utkarshminblr/PexTypo/Img/Screenshot 2026-10-20 132050.png

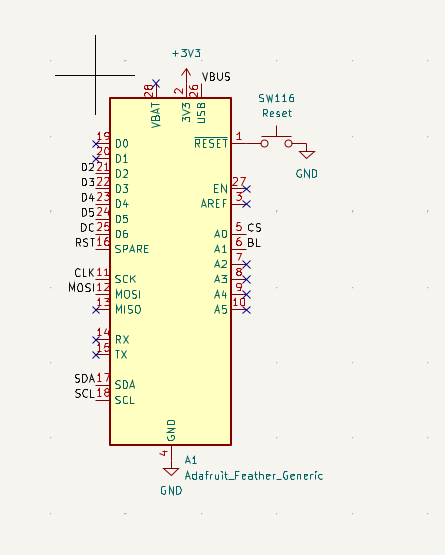
Img/Screenshot 2026-10-20 132050.png
