utkarshminblr/PexTypo/Img/Screenshot 2026-10-20 132104.png

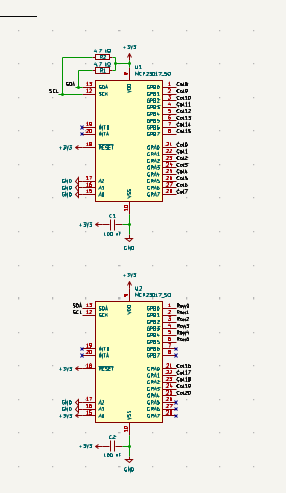
Img/Screenshot 2026-10-20 132104.png
