utkarshminblr/PexTypo/bom.csv

Name | Quantity | Total Cost ($) | Link | Distributor
3D-printed Case | 1 | 8 | https://printlegion.hackclub.com | Hack Club
PCB fabrication | 1 | 39.36 | https://cart.jlcpcb.com/shopcart/cart | JLCPCB
HITIME XVX Plum Blossom Shine Through Side Print Custom 75 Percent Dye Sub and Double Shot Keycaps, 136 Keys Cherry Profile Mechanical Keyboard Set | 1 | 43.47 | https://amzn.in/d/03Cm0nP8 | Amazon
DUROCK Stabilizers V3, Screw in Stabilizers with 2u, 6.25u, 7u Wires, PCB Mount for Mechanical Keyboards (Smokey 80% Kit) | 1 | 29.02 | https://amzn.in/d/09qbkcYf | Amazon
Akko V3 Creamy Blue Pro Keyboard Switch with Dustproof Stem for Mechanical Gaming Keyboard, 5-Pin 45gf Pre Lubed Tactile Key Switches (45pcs) | 3 | 81.03 | https://amzn.in/d/0btpna3L | Amazon
Adafruit Feather nRF52840 Express | 1 | 33.10 | https://www.theengineerstore.in/ta/products/adafruit-feather-nrf52840-express | theengineerstore
3.7V 500mAh LiPo Rechargeable Battery HCY-602030 | Lithium Polymer Battery Pack | DIY Projects, GPS, IoT Devices (Pack of 1) | 1 | 2.91 | https://amzn.in/d/0axbzTSW | Amazon
0.1uF/25V (100nF/25V) SMD Capacitor 0805 10% (Moq of 50) | 10 | 1.09 | https://amzn.in/d/02mNlnPe | Amazon
CL21B475KPQVPNE-Samsung-Cap Ceramic 4.7uF 10V X7R 10% Pad SMD 0805 125°C T/R Automotive AEC-Q200 | 5 | 0.16 | https://robu.in/product/cl21b475kpqvpne-samsung-cap-ceramic-4-7uf-10v-x7r-10-pad-smd-0805-125c-t-r-automotive-aec-q200/ | Robu
1N4148W SOD-123 1206 Diode | 216 | 1.65 | https://robu.in/product/1n4148w-sod-123-1206-diodereel-of-3000/ | Robu
3mm Green DIP LED | 15 | 0.14 | https://robu.in/product/3mm-green-dip-led-pack-of-50/ | Robu
3mm Red DIP LED | 15 | 0.13 | https://robu.in/product/3mm-red-dip-led-pack-of-50/ | Robu
TYPE-C-31-M-12-Hroparts-5A 1 16P Female Type-C SMD USB Connectors ROHS | 2 | 0.54 | https://robu.in/product/type-c-31-m-12-hroparts-5a-1-16p-female-type-c-smd-usb-connectors-rohs/ | Robu
SM08B-SRSS-TB(LF)(SN)-JST-1x8P 8P SH Tin 8 -25°C to +85°C 1A 1mm Copper Alloy Surface Mount SMD, P=1mm, Right Angle Wire-to-Board Connector ROHS | 2 | 1.56 | https://robu.in/product/sm08b-srss-tblfsn-jst-1x8p-8p-sh-tin-8-25%e2%84%8385%e2%84%83-1a-1-1mm-copper-alloy-surface-mount-smdp1mmsurface-mount%ef%bc%8cright-a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 | Robu
ERJ6ENF4701V-PANASONIC-SMD Chip Resistor, 4.7 kohm, ± 1%, 125 mW, 0805 [2012 Metric], Thick Film, Precision (MOQ 16) | 11 | 0.11 | https://robu.in/product/erj6enf4701v-panasonic-smd-chip-resistor-4-7-kohm-%c2%b1-1-125-mw-0805-2012-metric-thick-film-precision/ | Robu
CRCW08051K00FKEAHP-VISHAY-SMD Chip Resistor, 1 kohm, ± 1%, 500 mW, 0805 [2012 Metric], Thick Film, Pulse Proof, High Power | 20 | 0.66 | https://robu.in/product/crcw08051k00fkeahp-vishay-smd-chip-resistor-1-kohm-%c2%b1-1-500-mw-0805-2012-metric-thick-film-pulse-proof-high-power/ | Robu
RC0805JR-075K1L-Yageo-SMD Chip Resistor, 5.1 kohm, ± 5%, 125 mW, 0805 [2012 Metric], Thick Film, General Purpose | 100 | 0.18 | https://robu.in/product/rc0805jr-075k1l-yageo-smd-chip-resistor-5-1-kohm-%c2%b1-5-125-mw-0805-2012-metric-thick-film-general-purpose/ | Robu
MCP23017-E/SO MICROCHIP I/O Expander, 16 bit, I2C, Serial, 1.8 V, 5.5 V, SOIC, 28 Pins | 4 | 12.29 | https://robu.in/product/mcp23017-e-so-microchip-i-o-expander-16-bit-i2c-serial-1-8-v-5-5-v-soic-28-pins/ | Robu
USBLC6-2SC6-MS-MSKSEMI-4.5A 15V 150W 6V 5V SOT-23-6 ESD and Surge Protection (TVS/ESD) ROHS | 5 | 0.57 | https://robu.in/product/usblc6-2sc6-ms-msksemi-4-5a-15v-150w-6v-5v-sot-23-6-esd-and-surge-protection-tvs-esd-rohs/ | Robu
Waveshare 1.9inch LCD Display Module, SPI Interface, IPS, 262K Colors | 1 | 11.66 | https://robu.in/product/waveshare-lcd-display-module-spi-interface-262k-colors/ | Robu
Total |  | 267.64
