utkarshminblr/PexTypo/BOM img/Screenshot 2026-10-20 174808.png

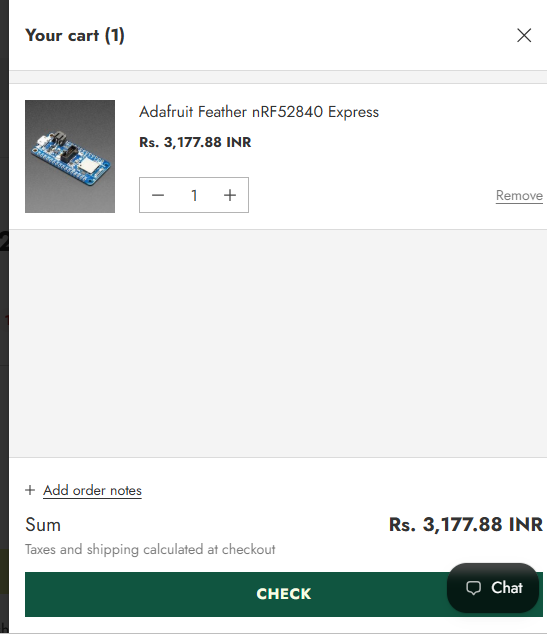
BOM img/Screenshot 2026-10-20 174808.png
