utkarshminblr/PexTypo/BOM img/Screenshot 2026-10-20 175236.png

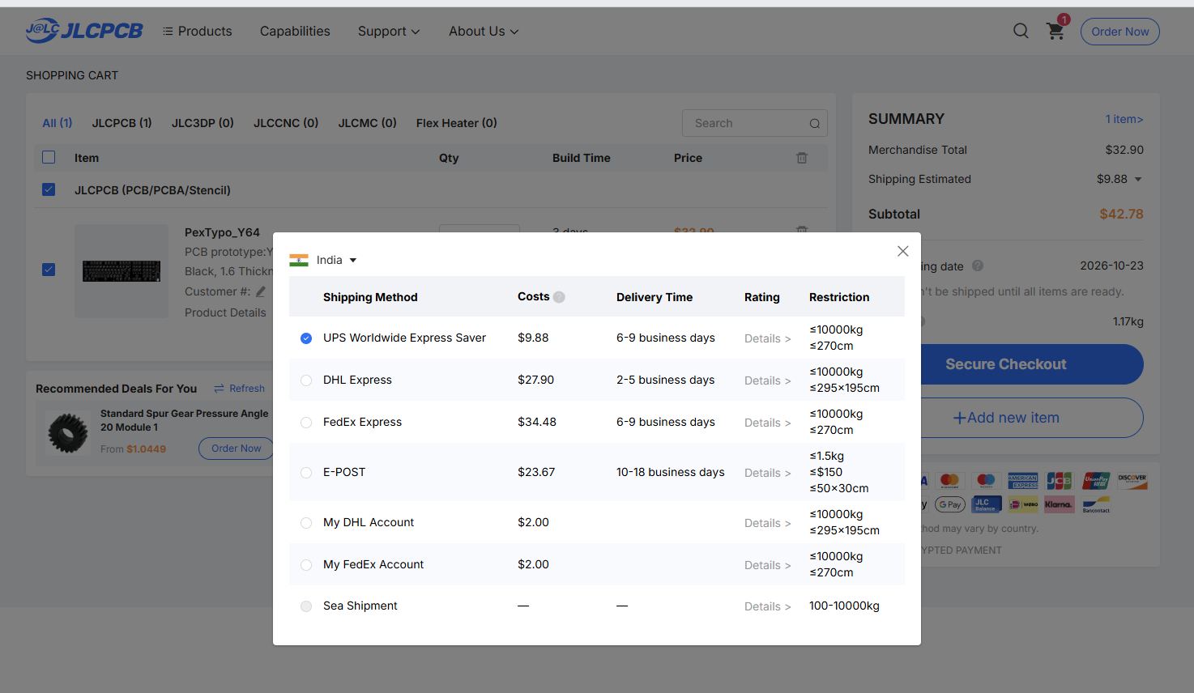
BOM img/Screenshot 2026-10-20 175236.png
