utkarshminblr/PexTypo/CAD/Full/Pextypo.step

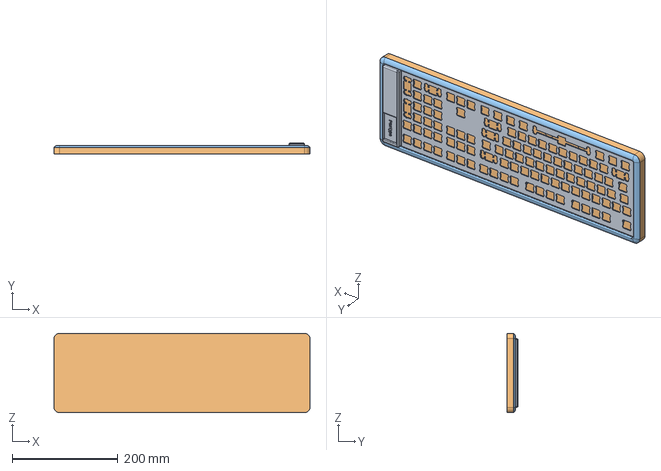
[picture p24: CAD file, 2026-10-20]
CAD/Full/Pextypo.step
485.0 x 20.5 x 150.0 mm
