utkarshminblr/PexTypo/CAD/Printable/Bottom.stl

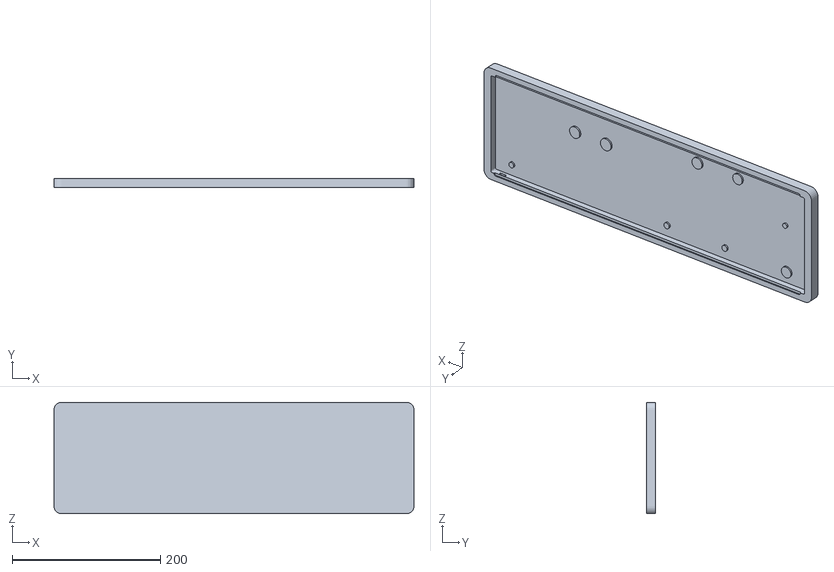
[picture p25: CAD file, 2026-10-20]
CAD/Printable/Bottom.stl
485.0 x 12.4 x 150.0
