utkarshminblr/PexTypo/CAD/Printable/Top Plate.stl

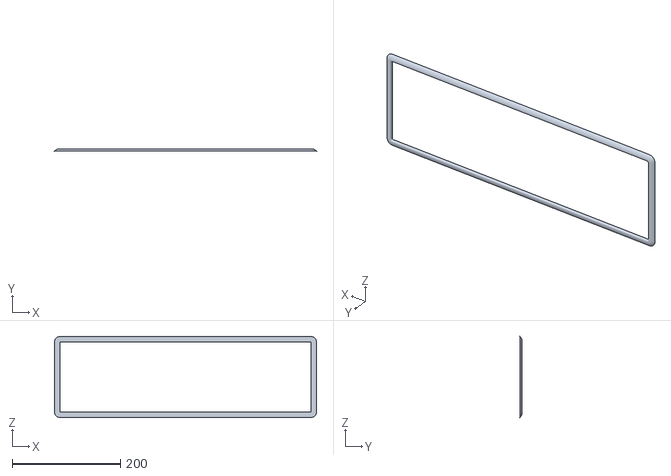
[picture p27: CAD file, 2026-10-20]
CAD/Printable/Top Plate.stl
485.0 x 4.00 x 150.0
