utkarshminblr/PexTypo/CAD/Printable/Plate.stl

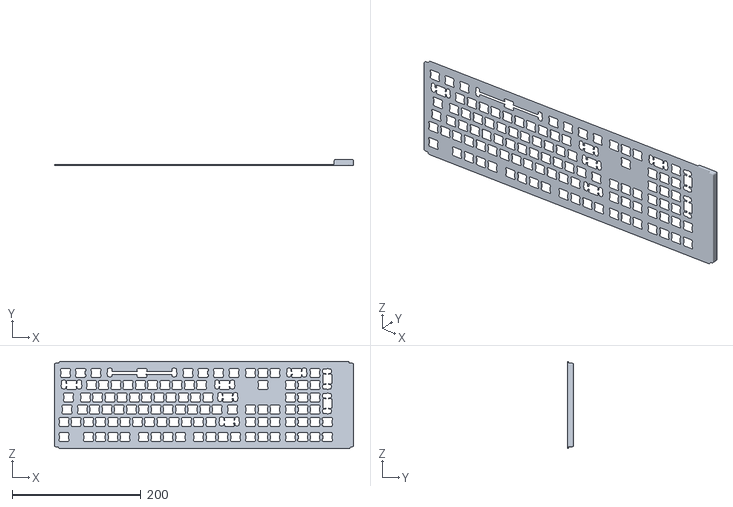
[picture p28: CAD file, 2026-10-20]
CAD/Printable/Plate.stl
465.0 x 9.50 x 136.0
