utkarshminblr/PexTypo/(list of files, cad)

Other CAD files:
Fusion File/Pextypo.f3d
