utkarshminblr/PexTypo/PDFs/PexTypo-B_Cu.pdf

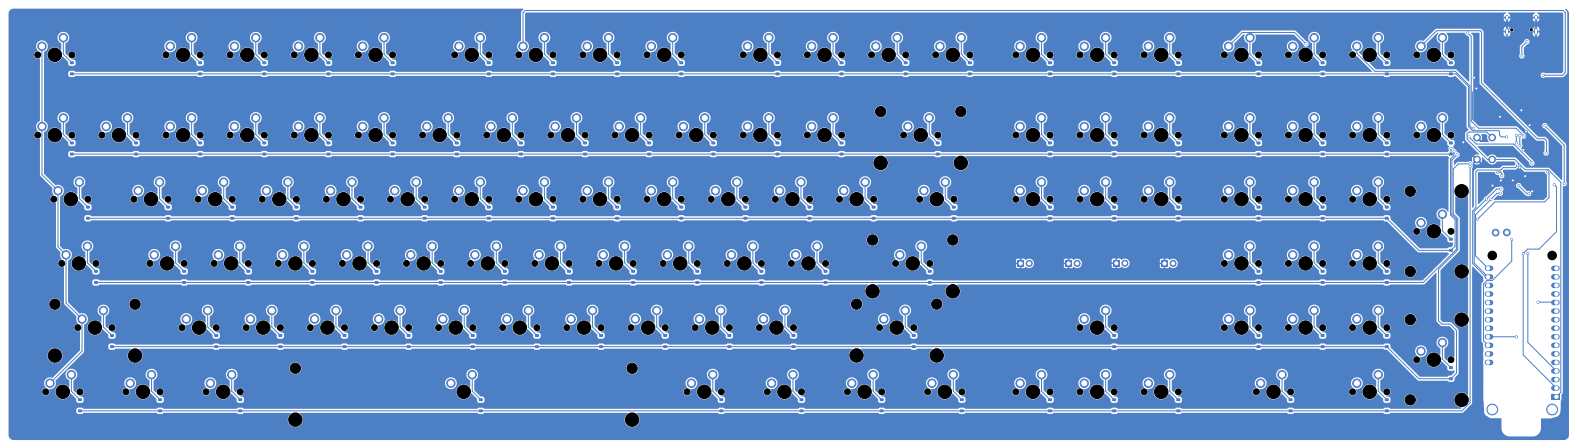
[picture p29: page 1]

Size: A2 | Rev:
KiCad E.D.A. 10.0.5 | Id: 2/9
