utkarshminblr/PexTypo/PDFs/PexTypo-B_Mask.pdf

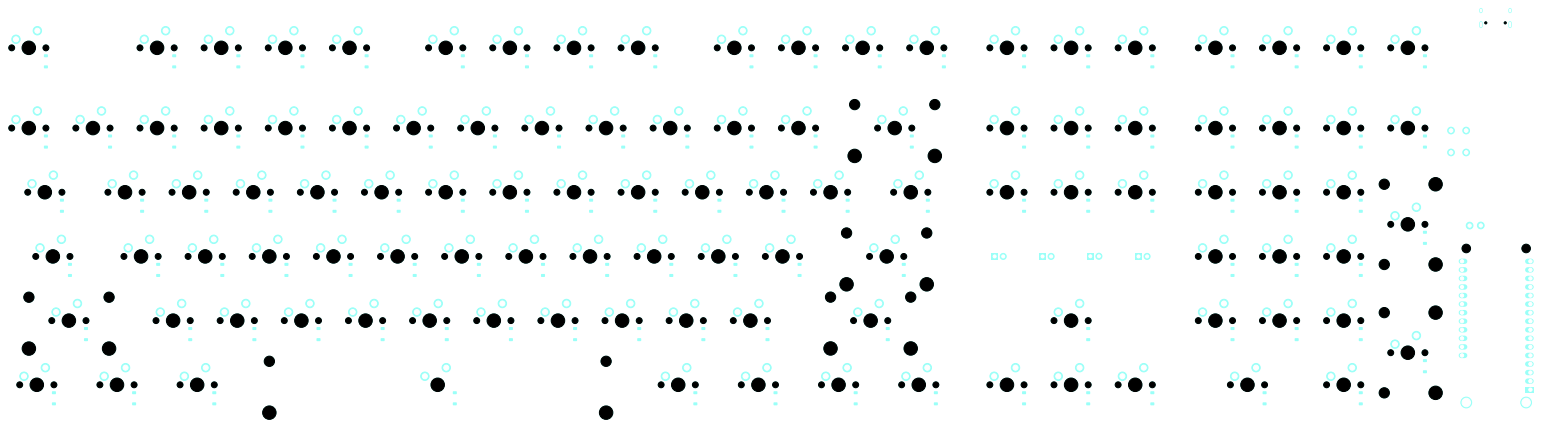
[picture p30: page 1]

Size: A2 | Rev:
KiCad E.D.A. 10.0.5 | Id: 8/9
