utkarshminblr/PexTypo/PDFs/PexTypo-B_Paste.pdf

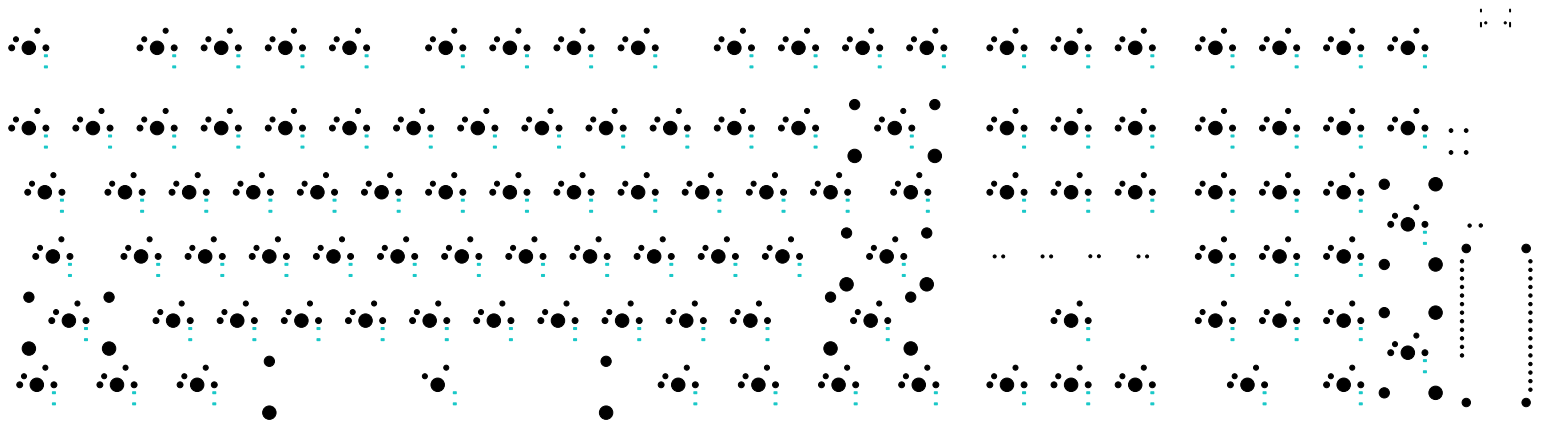
[picture p31: page 1]

Size: A2 | Rev:
KiCad E.D.A. 10.0.5 | Id: 4/9
