utkarshminblr/PexTypo/PDFs/PexTypo-B_Silkscreen.pdf

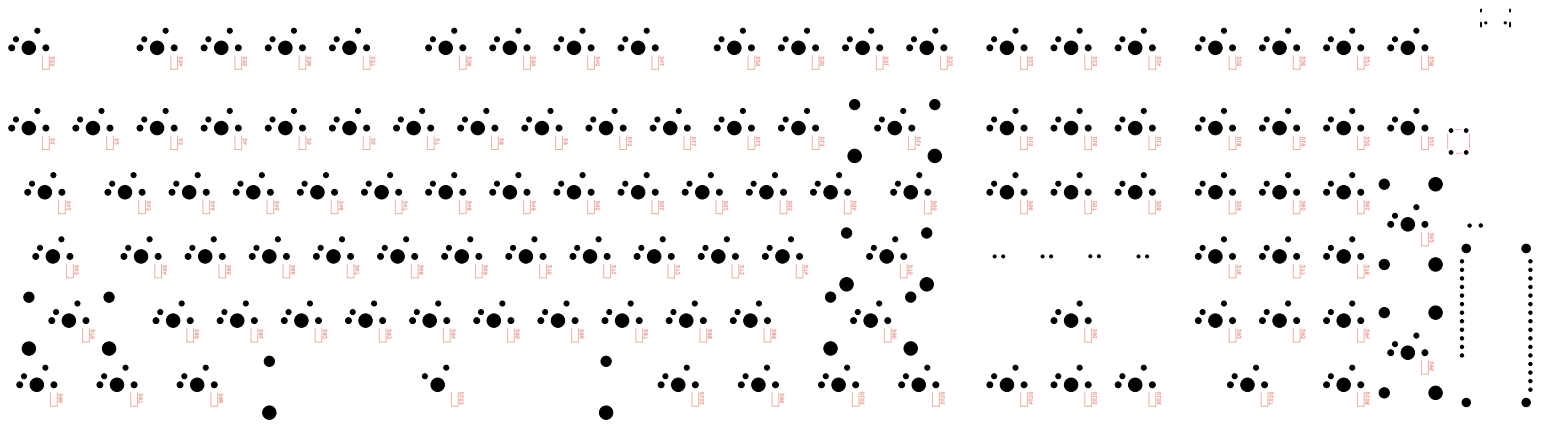
[picture p32: page 1]

Size: A2 | Rev:
KiCad E.D.A. 10.0.5 | Id: 6/9
