utkarshminblr/PexTypo/PDFs/PexTypo-Edge_Cuts.pdf

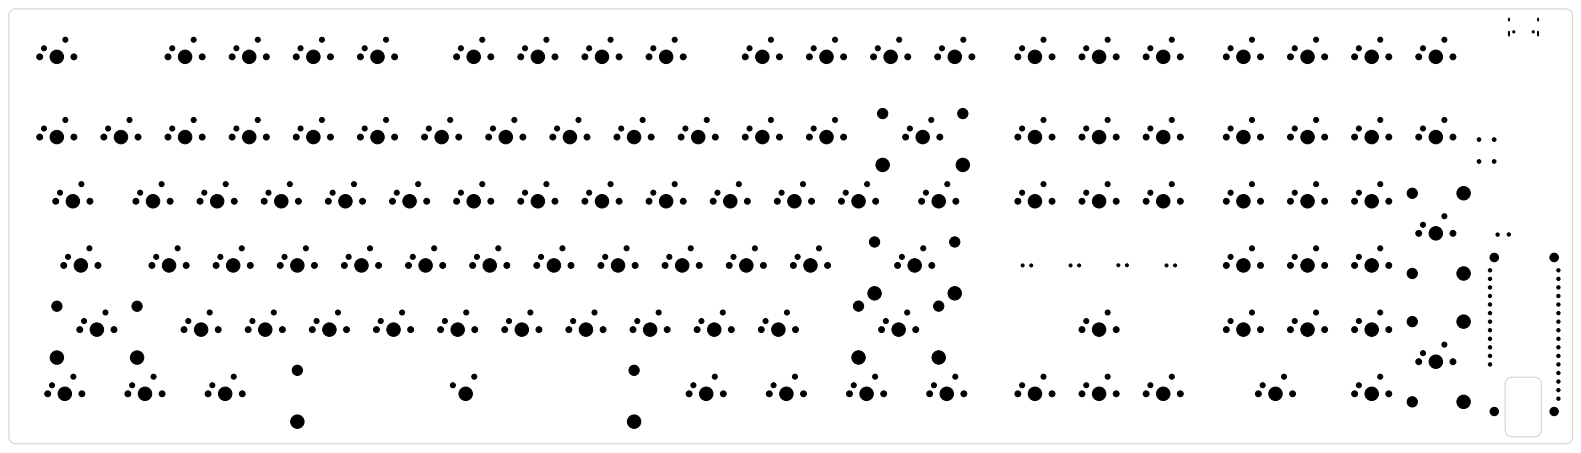
[picture p33: page 1]

Size: A2 | Rev:
KiCad E.D.A. 10.0.5 | Id: 9/9
