utkarshminblr/PexTypo/PDFs/PexTypo-F_Cu.pdf

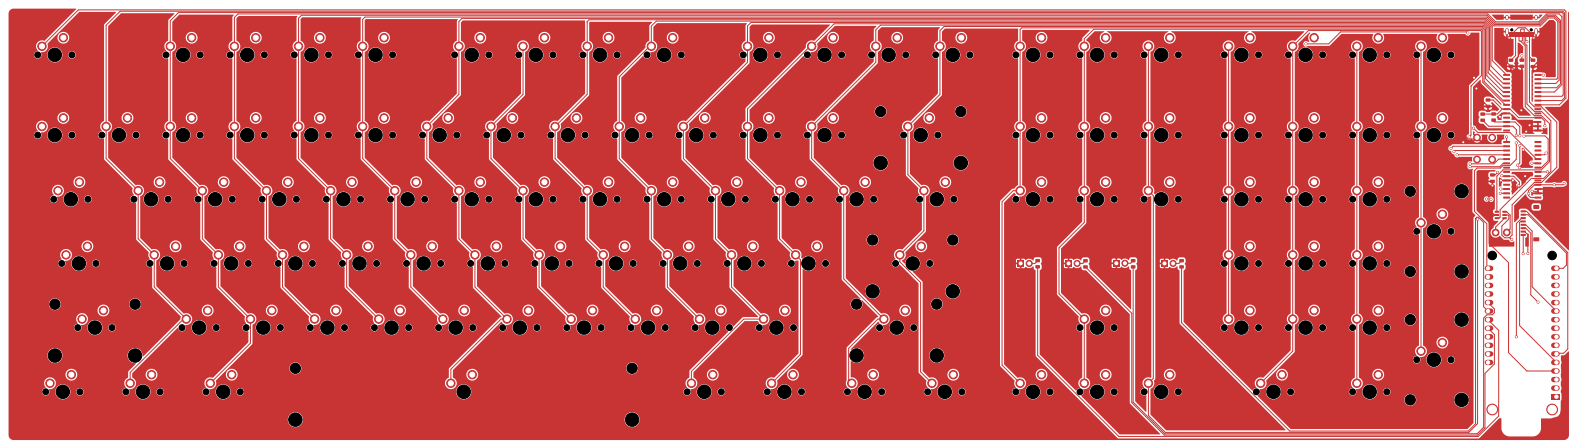
[picture p34: page 1]

Size: A2 | Rev:
KiCad E.D.A. 10.0.5 | Id: 1/9
