utkarshminblr/PexTypo/PDFs/PexTypo-F_Mask.pdf

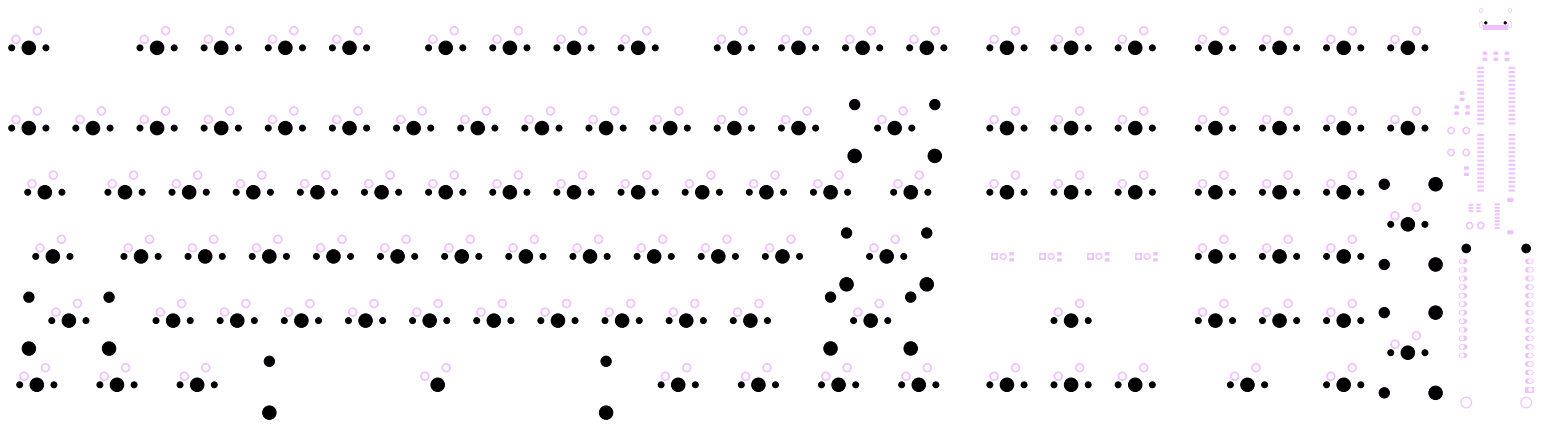
[picture p35: page 1]

Size: A2 | Rev:
KiCad E.D.A. 10.0.5 | Id: 7/9
