utkarshminblr/PexTypo/PDFs/PexTypo-F_Paste.pdf

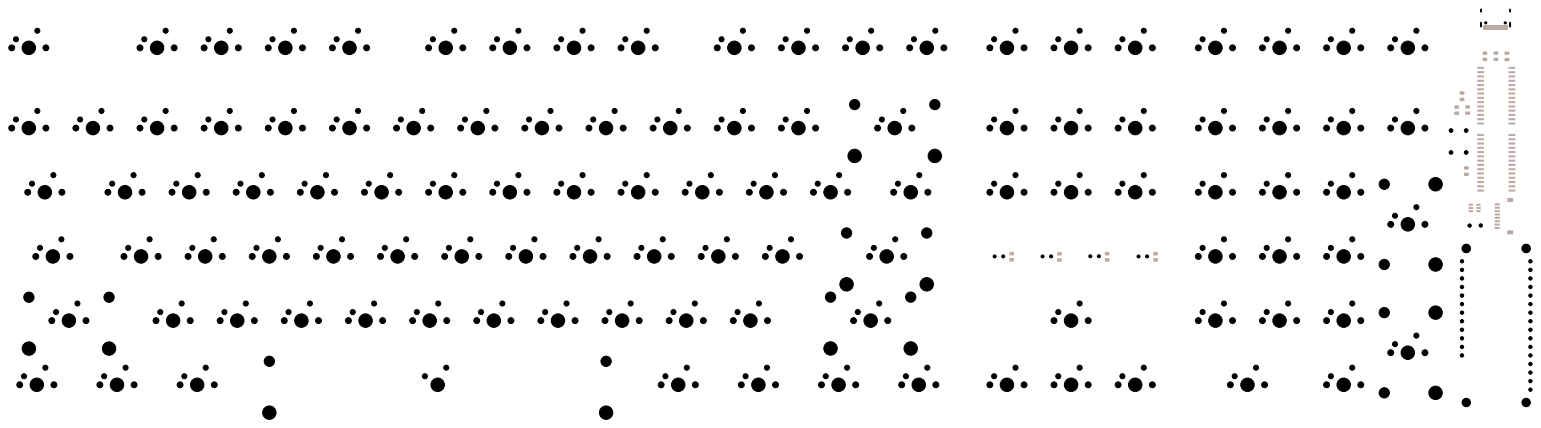
[picture p36: page 1]

Size: A2 | Rev:
KiCad E.D.A. 10.0.5 | Id: 3/9
