utkarshminblr/PexTypo/PDFs/PexTypo-F_Silkscreen.pdf

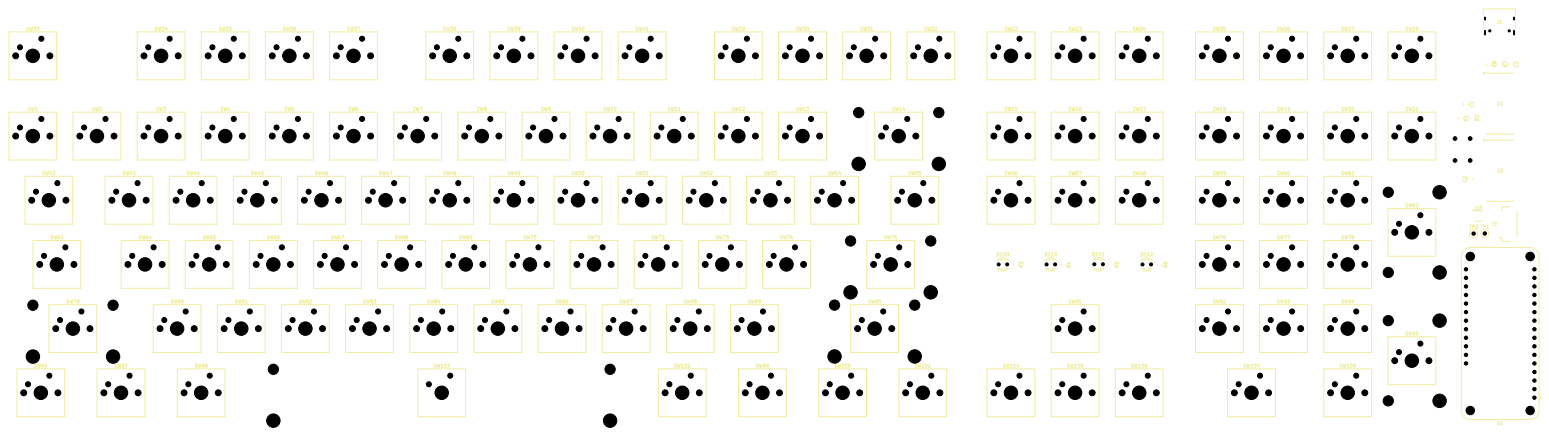
[picture p37: page 1]

Size: A2 | Rev:
KiCad E.D.A. 10.0.5 | Id: 5/9
